domokos/RS485_device/MFG/6_ow_bus_device/6_ow_bus_device.png

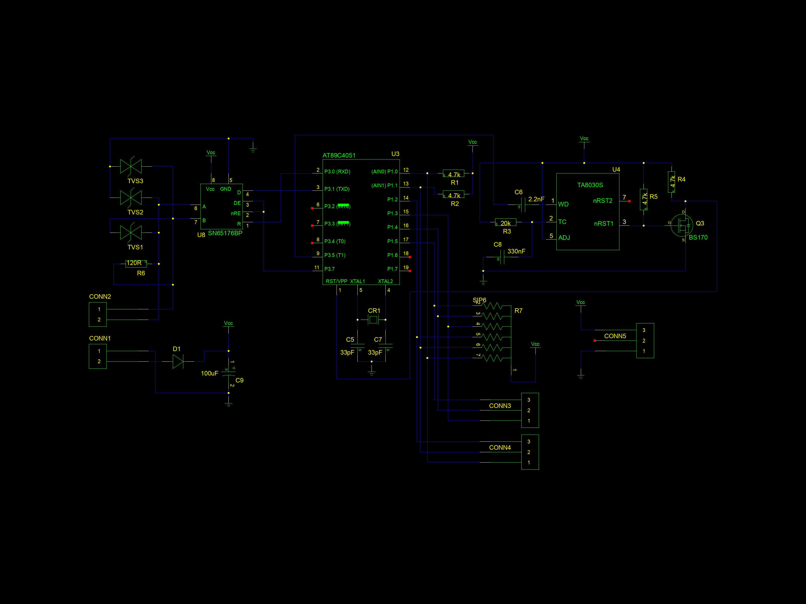
MFG/6_ow_bus_device/6_ow_bus_device.png
