domokos/RS485_device/MFG/master_controller/master_controller_v4.png

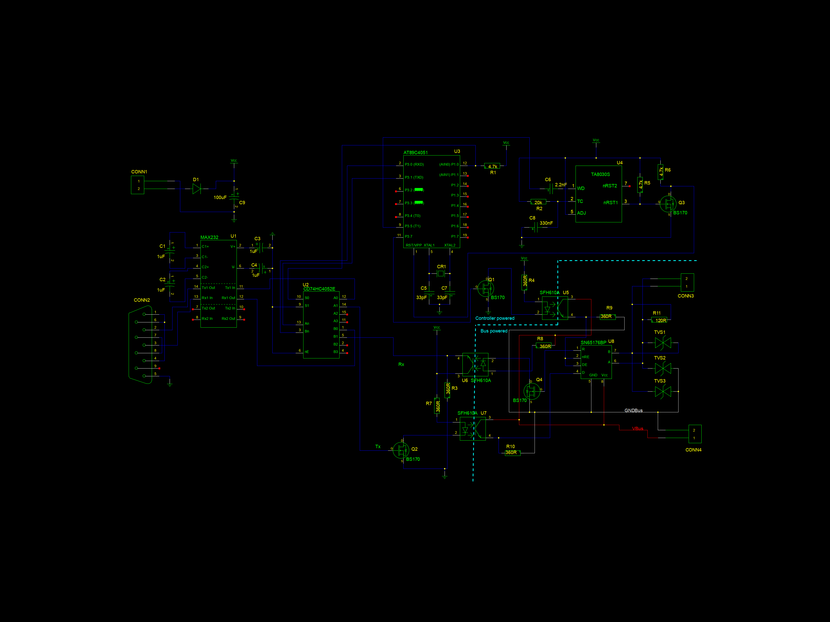
MFG/master_controller/master_controller_v4.png
