domokos/RS485_device/MFG/main_panel_device/230V_components.png

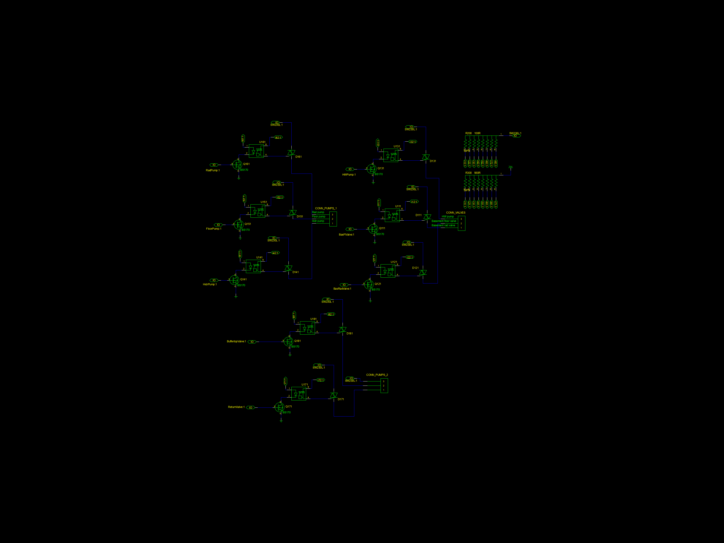
MFG/main_panel_device/230V_components.png
