domokos/RS485_device/MFG/main_panel_device/rs485_components.png

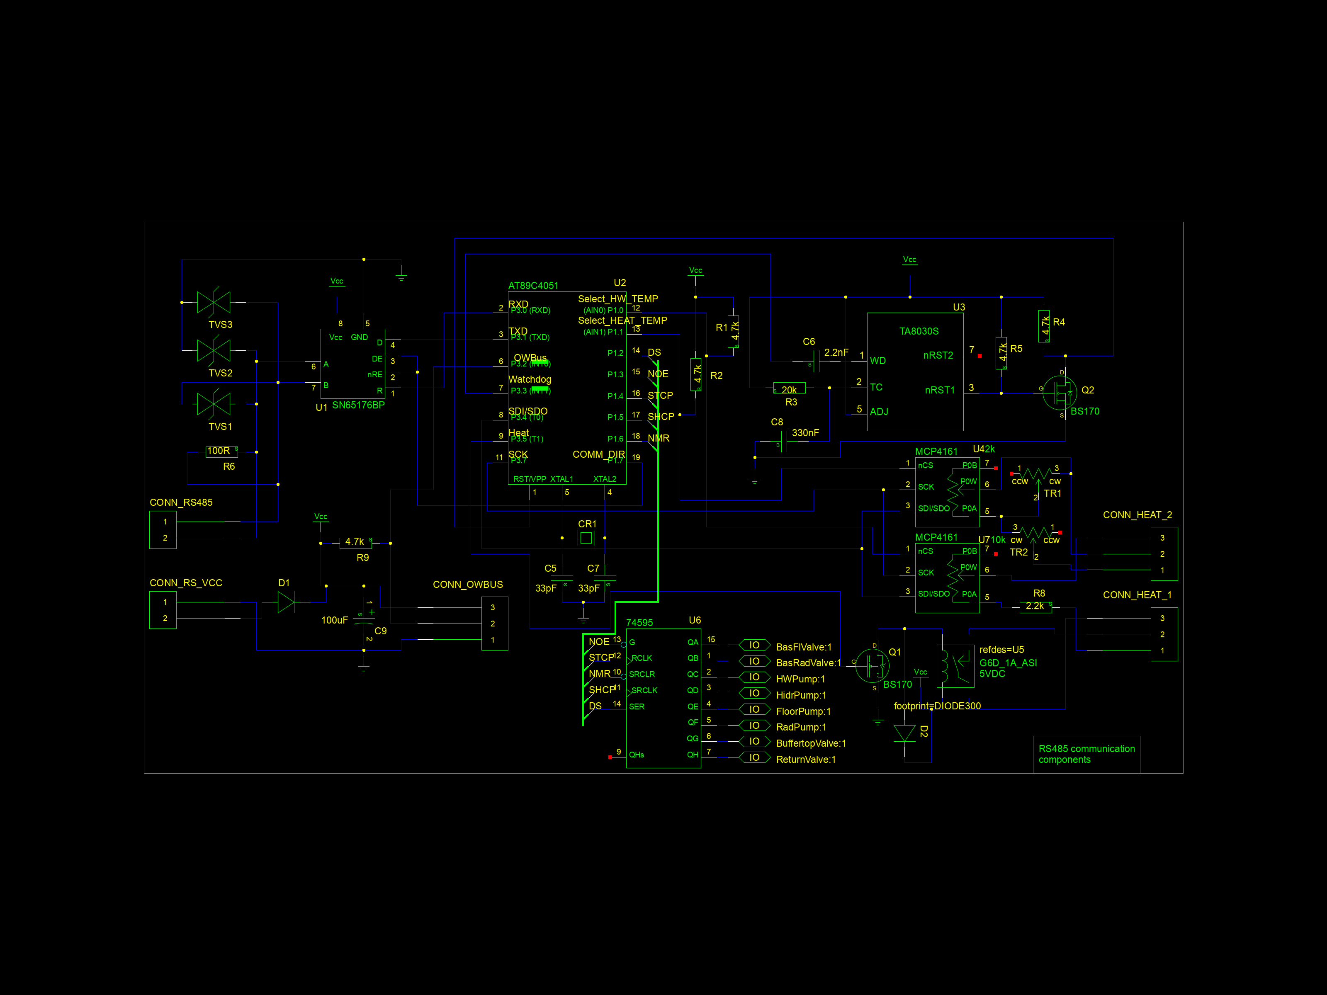
MFG/main_panel_device/rs485_components.png
