domokos/RS485_device/MFG/mixer_controller/230V_components.png

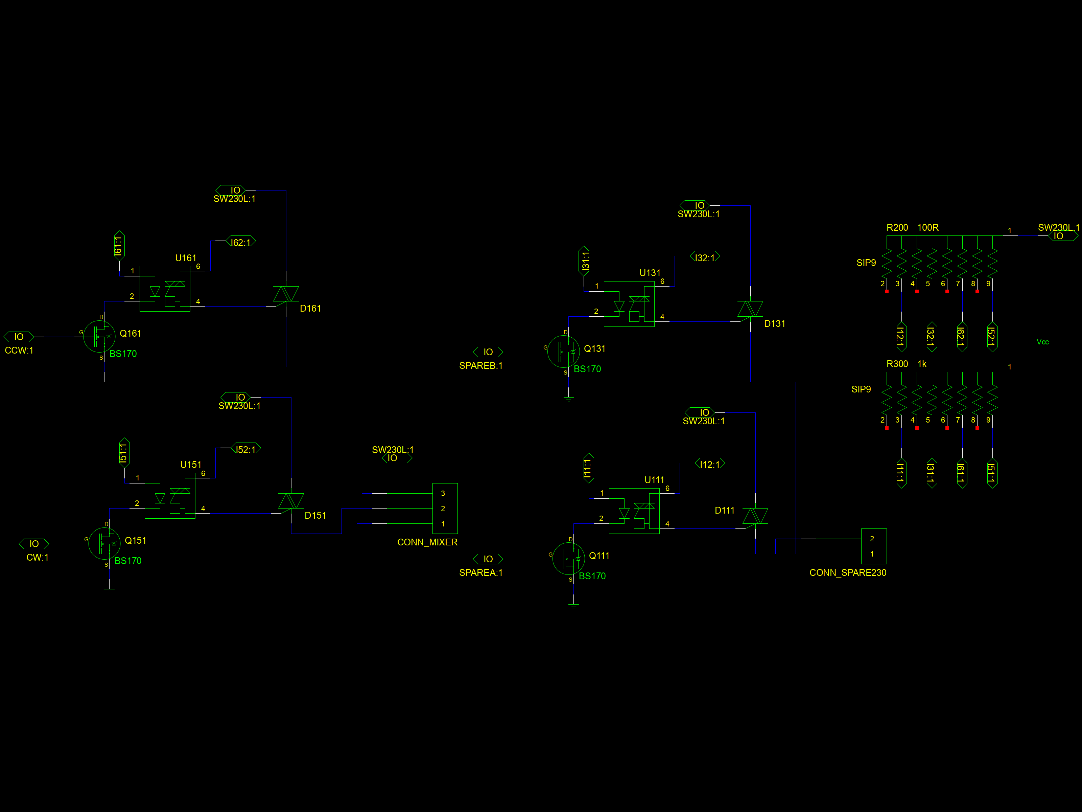
MFG/mixer_controller/230V_components.png
