domokos/RS485_device/MFG/mixer_controller/rs485_components.png

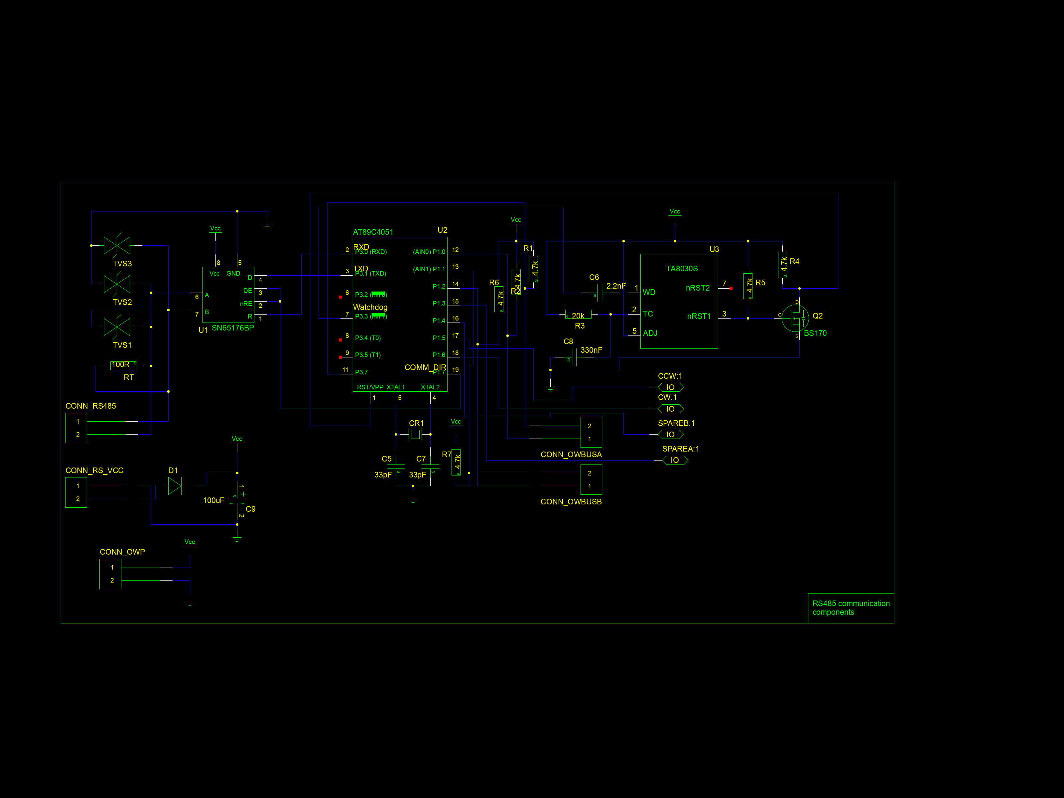
MFG/mixer_controller/rs485_components.png
