domokos/RS485_device/(list of files, drawings)

Other design files:
MFG/6_ow_bus_device/6_ow_bus_device.pcb
MFG/main_panel_device/main_panel_device.pcb
MFG/master_controller/master_controller_v4.pcb
MFG/mixer_controller/mixer_controller.pcb
