domokos/RS485_device/MFG/HP_device/HP_device.kicad_sch

## KiCad design MFG/HP_device/HP_device.kicad_sch (2022-10-01)

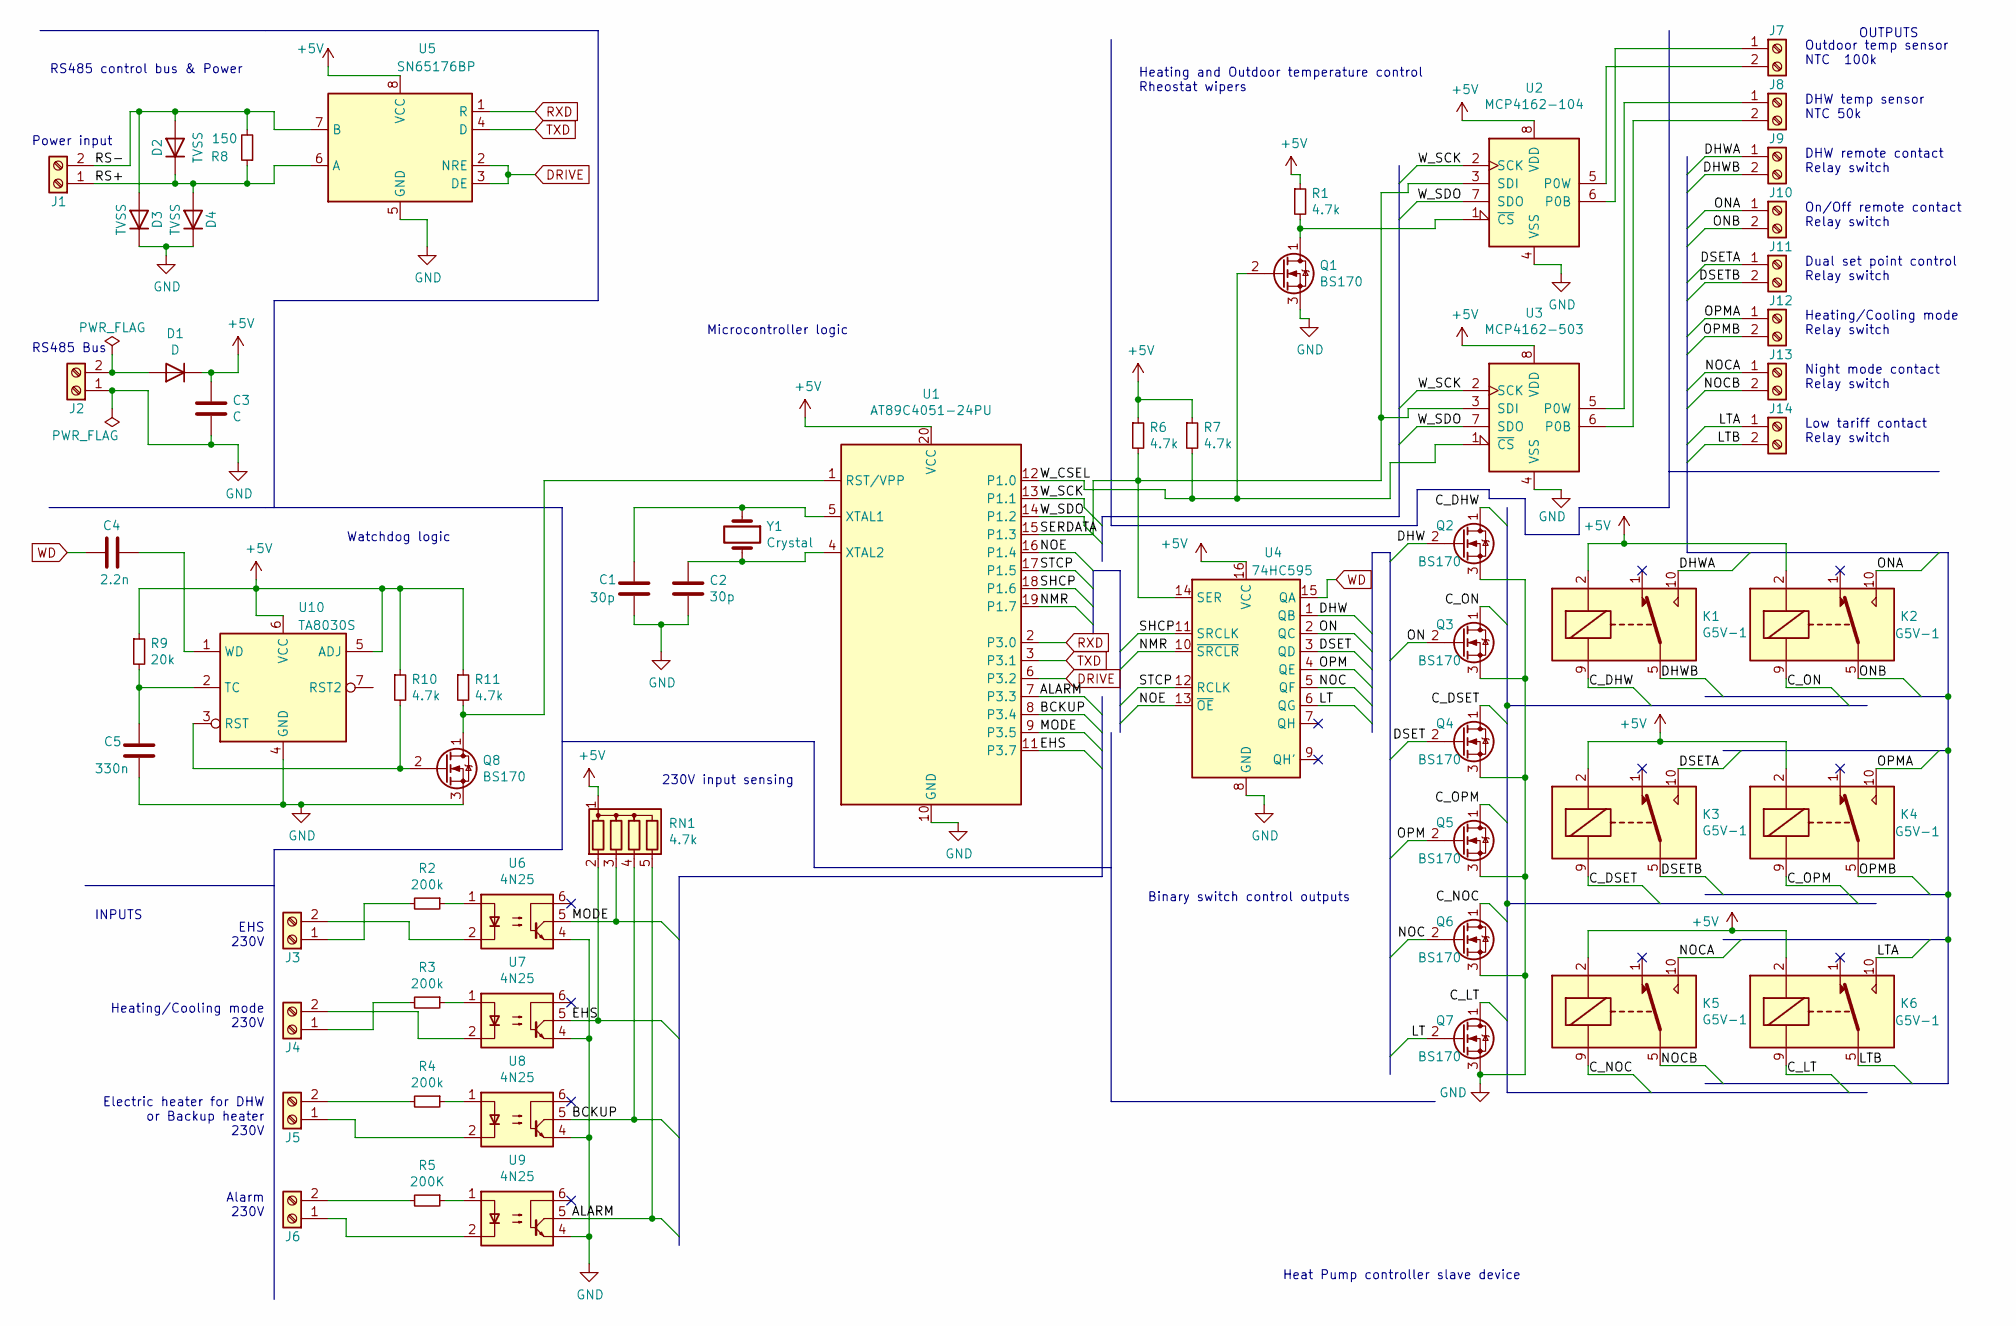
[picture p7: schematic HP_device.kicad_sch]

Parts:
C1, C2: 30p; C_Disc_D3.8mm_W2.6mm_P2.50mm
C3: C; C_Radial_D6.3mm_H11.0mm_P2.50mm
C4: 2.2n; C_Disc_D3.8mm_W2.6mm_P2.50mm
C5: 330n; C_Disc_D3.8mm_W2.6mm_P2.50mm
D1: D; D_A-405_P10.16mm_Horizontal
D2, D3, D4: TVSS; D_A-405_P10.16mm_Horizontal
J1, J2, J3, J4, J5, J6, J7, J8, J9, J10, J11, J12, J13, J14: Screw_Terminal_01x02; TerminalBlock_Phoenix_MKDS-1,5-2_1x02_P5.00mm_Horizontal
K1, K2, K3, K4, K5, K6: G5V-1; Relay_SPDT_Omron_G5V-1
Q1, Q2, Q3, Q4, Q5, Q6, Q7, Q8: BS170; TO-92_Inline
R1, R6, R7, R10, R11: 4.7k; R_Axial_DIN0204_L3.6mm_D1.6mm_P5.08mm_Horizontal
R2, R3, R4: 200k; R_Axial_DIN0309_L9.0mm_D3.2mm_P15.24mm_Horizontal
R5: 200K; R_Axial_DIN0309_L9.0mm_D3.2mm_P15.24mm_Horizontal
R8: 150; R_Axial_DIN0204_L3.6mm_D1.6mm_P5.08mm_Horizontal
R9: 20k; R_Axial_DIN0204_L3.6mm_D1.6mm_P5.08mm_Horizontal
RN1: 4.7k; R_Array_SIP5
U1: AT89C4051-24PU; DIP-20_W7.62mm
U2: MCP4162-104; DIP-8_W7.62mm
U3: MCP4162-503; DIP-8_W7.62mm
U4: 74HC595; DIP-16_W7.62mm
U5: SN65176BP; DIP-8_W7.62mm
U6, U7, U8, U9: 4N25; DIP-6_W7.62mm
U10: TA8030S; R_Array_SIP7
Y1: Crystal; Crystal_HC49-4H_Vertical

Connections:
+5V: C3.1, D1.1 (K), K1.2, K2.2, K3.2, K4.2, K5.2, K6.2, R1.1, R6.1, R7.1, R9.1, R10.1, R11.1, RN1.1 (common), U1.20 (VCC), U2.8 (VDD), U3.8 (VDD), U4.16 (VCC), U5.8 (VCC), U10.5 (ADJ), U10.6 (VCC)
ALARM: RN1.5 (R4), U1.7 (P3.3), U9.5
BCKUP: RN1.4 (R3), U1.8 (P3.4), U8.5
C_DHW: K1.9, Q2.1 (D)
C_DSET: K3.9, Q4.1 (D)
C_LT: K6.9, Q7.1 (D)
C_NOC: K5.9, Q6.1 (D)
C_ON: K2.9, Q3.1 (D)
C_OPM: K4.9, Q5.1 (D)
DHW: Q2.2 (G), U4.1 (QB)
DHWA: J9.1, K1.10
DHWB: J9.2, K1.5, K1.6
DRIVE: U1.6 (P3.2), U5.2 (NRE), U5.3 (DE)
DSET: Q4.2 (G), U4.3 (QD)
DSETA: J11.1, K3.10
DSETB: J11.2, K3.5, K3.6
EHS: RN1.2 (R1), U1.11 (P3.7), U7.5
GND: C1.2, C2.2, C3.2, C5.2, D3.1 (K), D4.1 (K), J2.1, Q1.3 (S), Q2.3 (S), Q3.3 (S), Q4.3 (S), Q5.3 (S), Q6.3 (S), Q7.3 (S), Q8.3 (S), U1.10 (GND), U2.4 (VSS), U3.4 (VSS), U4.8 (GND), U5.5 (GND), U6.4, U7.4, U8.4, U9.4, U10.4 (GND)
LT: Q7.2 (G), U4.6 (QG)
LTA: J14.1, K6.10
LTB: J14.2, K6.5, K6.6
MODE: RN1.3 (R2), U1.9 (P3.5), U6.5
NMR: U1.19 (P1.7), U4.10 (~SRCLR)
NOC: Q6.2 (G), U4.5 (QF)
NOCA: J13.1, K5.10
NOCB: J13.2, K5.5, K5.6
NOE: U1.16 (P1.4), U4.13 (~OE)
unnamed: C1.1, U1.5 (XTAL1), Y1.1
unnamed: C2.1, U1.4 (XTAL2), Y1.2
unnamed: C4.2, U10.1 (WD)
unnamed: C5.1, R9.2, U10.2 (TC)
unnamed: D1.2 (A), J2.2
unnamed: J3.1, R2.2
unnamed: J3.2, U6.2
unnamed: J4.1, R3.2
unnamed: J4.2, U7.2
unnamed: J5.1, U8.2
unnamed: J5.2, R4.2
unnamed: J6.1, U9.2
unnamed: J6.2, R5.2
unnamed: J7.1, U2.6 (P0B)
unnamed: J7.2, U2.5 (P0W)
unnamed: J8.1, U3.5 (P0W)
unnamed: J8.2, U3.6 (P0B)
unnamed: Q1.1 (D), R1.2, U2.1 (~CS)
unnamed: Q8.1 (D), R11.2, U1.1 (RST/VPP)
unnamed: Q8.2 (G), R10.2, U10.3 (RST)
unnamed: R2.1, U6.1
unnamed: R3.1, U7.1
unnamed: R4.1, U8.1
unnamed: R5.1, U9.1
ON: Q3.2 (G), U4.2 (QC)
ONA: J10.1, K2.10
ONB: J10.2, K2.5, K2.6
OPM: Q5.2 (G), U4.4 (QE)
OPMA: J12.1, K4.10
OPMB: J12.2, K4.5, K4.6
RS+: D2.1 (K), D4.2 (A), J1.1, R8.1, U5.6 (A)
RS-: D2.2 (A), D3.2 (A), J1.2, R8.2, U5.7 (B)
RXD: U1.2 (P3.0), U5.1 (R)
SERDATA: R6.2, U1.15 (P1.3), U2.3 (SDI), U3.3 (SDI), U4.14 (SER)
SHCP: U1.18 (P1.6), U4.11 (SRCLK)
STCP: U1.17 (P1.5), U4.12 (RCLK)
TXD: U1.3 (P3.1), U5.4 (D)
WD: C4.1, U4.15 (QA)
W_CSEL: Q1.2 (G), R7.2, U1.12 (P1.0), U3.1 (~CS)
W_SCK: U1.13 (P1.1), U2.2 (SCK), U3.2 (SCK)
W_SDO: U1.14 (P1.2), U2.7 (SDO), U3.7 (SDO)

Notes on the sheet:
DHW temp sensor NTC 50k
Outdoor temp sensor NTC 100k
Dual set point control Relay switch
Heat Pump controller slave device
DHW remote contact Relay switch
Binary switch control outputs
OUTPUTS
Low tariff contact Relay switch
Heating and Outdoor temperature control Rheostat wipers
Heating/Cooling mode Relay switch
On/Off remote contact Relay switch
Watchdog logic
EHS 230V
Night mode contact Relay switch
RS485 control bus & Power
RS485 Bus
Microcontroller logic
Electric heater for DHW or Backup heater 230V
Alarm 230V
230V input sensing
Heating/Cooling mode 230V
INPUTS
Power input
