domokos/RS485_device/Devices/Mixer_controller.h

/*
 * Mixer_controller.h
 *
 *  Created on: Jan 30, 2015
 *      Author: dmolnar
 */

#ifndef MIXER_CONTROLLER_H_
#define MIXER_CONTROLLER_H_

#include "Slave_comm.h"

typedef enum {DIRECTION_CW, DIRECTION_CCW} direction_type;

#endif /* MIXER_CONTROLLER_H_ */
