domokos/RS485_device/Devices/Master_controller.h

/*
 * Master_controller.h
 *
 *  Created on: Feb 18, 2013
 *      Author: dmolnar
 */

#ifndef MASTER_CONTROLLER_H_
#define MASTER_CONTROLLER_H_

#include "Master_comm.h"

#endif /* MASTER_CONTROLLER_H_ */
