domokos/RS485_device/(commit log)

2012-10-29 Fix ignoring build componenst on desktop.
    [Comm.c]
2012-10-29 Fix encoding to ISO-8859-2.
    [Comm.c]
2012-10-30 Correct typo of buffer clearing.
    [Comm.c]
2012-10-30 Review and fix message escaping logic
    [Comm.c]
2012-10-31 Fix: Put ISR prototypes in the same file that contains main().
    [Base.c, Base.h, Comm.c, Comm.h]
2012-11-01 Fix interrupt enable and send buffer numbering.
    [Base.c, Comm.c, Comm.h]
2012-11-01 Fix messaging logic sync based on emulator tests.
    [Comm.c, Comm.h]
2012-11-04 Implement flip_bit - not yet tested
    [Comm.c, Comm.h]
2012-11-05 Clear up flip_bits function.
    [Comm.c]
2012-11-06 Bring bit flipping into the crc calculation. Not yet tested in emulator.
    [Comm.c]
2012-11-06 16 bit CSR calculation works with flippped bits in ermulator.
    [Comm.c, Comm.h]
2013-01-29 Create own header file for at89c4051 registers to handle eclipse errors.
    [Base.c, Base.h, Comm.c, Comm.h, at89c4051.h]
2013-02-07 Fix documetation typos and cleanup prev_recieved char in Comm.c
    [Comm.c, Comm.h]
2013-02-11 Fix some typo in comments and in CRC_ERROR #define
    [Comm.h]
2013-02-13 Add a second train to the end of the message to ensure bus direction timing correctness
    [Comm.c]
2013-02-16 Cleanup and implement circular buffer based UART communication
2013-02-18 Reorganize into devices and master controller step1
2013-02-18 Fix macros in headers
    [Comm.h, Comm_common.h]
2013-02-19 Start implementing timer1 clock based messaging timeout counter for reliability and for bus master messaging timeout measurements.
2013-02-20 Update calculations
    [Timeout_calculation.xlsx]
2013-02-21 Reorganized delay and timeout to correct time base and test it in emulator.
    [Base.c, Base.h, Comm_common.c, Comm_common.h, Master_comm.c, Slave_comm.c, Slave_comm.h]
2013-02-23 Workaround SDCC bug. Tested on protoboard. Works.
    [Comm_common.c, Comm_common.h, Master_comm.c]
2013-03-01 Start temp measuring device and reorganize comm_speed based on two crystal speeds.
2013-03-01 Reorganized for generic device.
    [Timeout_calculation.xlsx]
2013-03-02 Start temp reader device testing in emulator.
2013-03-03 Communicates temperature correctly on protoboard.
    [Base.c, Base.h, Onewire.c]
2013-03-04 Investigating timeout. Not yet found.
    Device sometimes does not respond to messages getting to UART pin for
    unknown reason.
2013-03-06 COmm error rate down to 4%. Hmmmm.
    [Comm_common.c, Comm_common.h, Generic_device.c]
2013-03-06 Still errors a bit.
    [Comm_common.c, Comm_common.h]
2013-03-06 Fixed timeout errors. Timeout error rate below 0.1%
    [Base.c, Comm_common.c]
2013-03-12 Refine timer in Base and equalize interrupt priorities
2013-03-12 Change watchdog pin.
2013-03-12 Add schematics
    [master_controller.sch]
2013-03-13 Start drawing schematic.
    [master_controller.sch]
2013-03-14 Finish schematic.
    [master_controller.sch]
2013-03-14 Add resistor to opto source.
    [master_controller.sch]
2013-03-15 Add symbols, finalize schematic.
    [master_controller.sch]
2013-03-15 Schematics refining
    [master_controller.sch]
2013-03-15 Finalize resistor values.
    [master_controller.sch]
2013-03-16 Change crystal frequency and make init timer pulic.
2013-03-16 Reorganize schematics and pcbs
    [master_controller.pcb, master_controller.sch]
2013-03-17 Work on pcb
    [master_controller.pcb, master_controller.sch]
2013-03-17 Finish PCB board.
    [master_controller.pcb, master_controller.sch]
2013-03-17 Refine serial tx.
    [master_controller.pcb]
2013-03-17 fix packaging of optocoupler.
    [master_controller.sch]
2013-03-18 Refine pcb once more.
    [master_controller.pcb, master_controller.sch]
2013-03-18 Add onewire 3 device
    [3_ow_bus_device.pcb, 3_ow_bus_device.sch]
2013-03-20 Rename things
    [6_ow_bus_device.pcb, 6_ow_bus_device.sch]
2013-03-21 CONN3.fp added
    [3_ow_bus_device.pcb, 3_ow_bus_device.sch]
2013-03-21 Finalize elements in ow6 layout
    [6_ow_bus_device.pcb]
2013-03-21 Finish PCB
    [6_ow_bus_device.pcb]
2013-03-21 fixups on layout.
    [6_ow_bus_device.pcb, 6_ow_bus_device.sch]
2013-03-22 Prited PCBs.
    [6_ow_bus_device.pcb, master_controller.pcb]
2013-03-23 Add alignment marks to PCB layout
    [6_ow_bus_device.pcb, master_controller.pcb]
2013-03-25 Test the panel. MOdify watchdog resistor and ADJ values.
    [6_ow_bus_device.pcb, 6_ow_bus_device.sch, master_controller.pcb, master_controller.sch]
2013-03-29 Start drawing switch panel device
    [6_ow_bus_device.pcb, switch_panel_device.sch]
2013-03-30 Add structure for main panel device based on generid test device.
2013-04-01 PWM is complete. Need to add PWM mesage handling before testing.
2013-04-02 Implemented multiple OW devices on a single bus. Needs testing.
2013-04-02 PWM and single OW tested in hardware. Works. To be tested mutiple OW on a bus.
2013-04-03 Reorganize PWM
2013-04-03 OPtimize PWM state machine.
2013-04-03 Tested in device. Works.
2013-04-08 ROM ID read succesfully with test device.
2013-04-09 Multiple OW devices on single bus works, tested in Main Panel Device.
2013-04-11 Reorganize panels and add comm safety to Master controller.
    [kazan_a_v3.sch, kazan_b_v3.sch, main_panel_device.sch]
2013-04-13 Prepare branching comm for interrupt driven serial receiving.
2013-04-13 Fix eclipse parser mocking.
    [Base.h]
2013-04-15 Timeputing fixed, now test why master controller sends a short message to the bus sometimes.
    [Comm_common.c]
2013-04-16 Some ISR-receiver hadshaking and timeout fixes before testing.
    [Comm_common.c]
2013-08-04 Modify layout of 6owbus - join powe & GND lines to a single connector.
    [6_ow_bus_device.pcb, 6_ow_bus_device.sch]
2013-08-23 Add 6 ow bus device.
2013-08-25 OW interface of 6 OW bus device tested.
2013-08-28 Add alternative Master controller PCB
    [master_controller_v2.pcb]
2013-08-29 New master controller version (v3)
    [master_controller_v3.pcb]
2013-08-31 Modify master controller layout
    [master_controller_v3.pcb]
2013-08-31 Fine tune master controller pcb
    [master_controller_v3.pcb, master_controller_v3.sch]
2013-09-01 Finalize Master controller PCB layout
    [master_controller_v3.pcb]
2013-09-03 Fine tune layout and add printed ps file
    [master_controller_v3.pcb]
2013-09-16 Fix optocoupler in master_controller MFG
    [master_controller_v3.pcb, master_controller_v3.sch]
2013-10-01 New version of master_controller MFG
    [master_controller_v4.pcb, master_controller_v4.sch]
2013-12-28 Continue Design of main panel device
    [230V_components.sch, 230V_control.sch, rs485_components.sch]
2014-01-05 Refine main?panel_device and clenup master controller old versions.
    [230V_components.sch, 230V_control.sch, master_controller.sch, master_controller_v2.pcb, master_controller_v3.pcb, master_controller_v3.sch, rs485_components.sch]
2014-01-19 Main controller PCB design started
    [230V_components.sch, 230V_control.sch, main_panel_device.pcb]
2014-01-19 Further elaborate main controller MFG.
    [230V_components.sch, 230V_control.sch, main_panel_device.pcb, rs485_components.sch]
2014-01-23 Fix missing resistor and add 230V signal components
    [230V_control.sch, main_panel_device.pcb]
2014-01-25 Create 230V parts of board
    [main_panel_device.pcb]
2014-01-26 Finish first version of PCB fine tune layout connections.
    [230V_components.sch, main_panel_device.pcb, rs485_components.sch]
2014-02-08 Fix wirting of optocoupler inputs.
    [230V_control.sch, main_panel_device.pcb]
2014-02-08 fix capacitor value for 230V components.
    [230V_control.sch]
2014-03-03 Change 230V capacitor to a bigger one.
    [230V_control.sch, main_panel_device.pcb]
2014-03-16 Add a different size line capacitor.
    [main_panel_device.pcb]
2014-03-17 Fine tune layout
    [main_panel_device.pcb]
2014-05-02 Add text and alignment mark to main panel PCB
    [main_panel_device.pcb]
2014-11-13 Modify main panel device for new condensing boiler.
    [230V_components.sch, 230V_control.sch, kazan_a_v3.sch, kazan_b_v3.sch, main_panel_device.pcb, rs485_components.sch]
2014-11-17 Revert a file
    [230V_components.sch, rs485_components.sch]
2014-11-17 Refine layout
    [main_panel_device.pcb, rs485_components.sch]
2014-11-18 Finalize board before printing
    [main_panel_device.pcb]
2014-11-23 Finalize layout. Correct Triac pinout and schematic.
    [230V_components.sch, main_panel_device.pcb, rs485_components.sch]
2014-11-23 Fix relay pcb in main panel board
    [main_panel_device.pcb]
2014-11-25 Fixed missing component from main panel device
    [main_panel_device.pcb, rs485_components.sch]
2014-11-26 Fixes of the main panel device after first debugging session.
    [master_controller.pcb]
2014-11-27 Fix spi timing for MCP4161
    [MCP4161.c, MCP4161.h]
2014-11-30 Onewire device addresses set for final operation.
2014-12-01 Fix HW problems and test.
    [Main_panel_device.c]
2014-12-01 Fix scaling of DS18B20 to 12 bit value (multiply with 0.625 to get real temperature)
    [Main_panel_device.c]
2014-12-01 Fix typo in scaling
    [Main_panel_device.c, Main_panel_device.h]
2014-12-07 Re-fix wiper write volatility
    [MCP4161.c]
2014-12-07 Fix reading wiper volatility flag
    [Main_panel_device.c]
2014-12-14 Branch for time-distributed sensor read on the single bus
2014-12-15 Rework main panel schematic
    [rs485_components.sch]
2014-12-16 Finalize schematics - add 2 new switches and a rheostat
    [230V_components.sch, rs485_components.sch]
2014-12-16 Fix missing elemnt refdes' and update layout - now complete with elements.
    [230V_components.sch, main_panel_device.pcb, rs485_components.sch]
2014-12-16 Add original rheostat drawing
    [rheostat.sch]
2014-12-17 Start working on pcb layout
    [230V_components.sch, main_panel_device.pcb, rs485_components.sch]
2014-12-18 Develop layout further
    Please enter the commit message for your changes. Lines starting
    [main_panel_device.pcb, rs485_components.sch]
2014-12-18 Finish Layout
    [230V_components.sch, main_panel_device.pcb, rs485_components.sch]
2014-12-18 Reduce vias in the pcb
    [main_panel_device.pcb]
2014-12-19 Remove some vias
    [main_panel_device.pcb]
2014-12-19 Add attachment hole measure to the pcb
    [main_panel_device.pcb]
2014-12-24 Add mounting holes to pcb
    [230V_components.sch, main_panel_device.pcb, rs485_components.sch]
2014-12-25 Reorganize board to make moore room
    [main_panel_device.pcb]
2014-12-25 Finalize layout
    [main_panel_device.pcb, rs485_components.sch]
2014-12-26 Create hidraulic schematic
    [hirdaulic_drawing.sch]
2014-12-26 Add alignment marks to the pcb layout
    [main_panel_device.pcb]
2014-12-26 Rename file
    [hidraulic_drawing.sch]
2014-12-27 Modify hidraulic drawing
    [hidraulic_drawing.sch]
2014-12-28 Ready to test Buffer branch in real HW
    [230V_components.sch, main_panel_device.pcb, rs485_components.sch]
2014-12-29 MOve main panel device to single extender code
2014-12-29 Adjust main panel device inactivity self-reset timeout to 30 sec
    [Slave_comm.h]
2014-12-31 Disable messaging timeout as it did not work.
    [Main_panel_device.c]
2014-12-31 Fix a timer interrupt race condition and re-enable bus communication timeout code
    [Base.c, Main_panel_device.c]
2014-12-31 Fix pinlayout defines by introducing device specfic compiler defines
    [Base.h, Master_comm.c, Pinlayout.h, Slave_comm.c]
2014-12-31 Make all pind device type define dependent
2015-01-01 Fix defines for Exclipes CDT parser
    [Pinlayout.h]
2015-01-03 Fix typo of Exclipse parser name
    [Pinlayout.h]
2015-01-03 Start HW testing six owbus device
2015-01-03 HW assembled for testing
2015-01-03 Fix direction pin
2015-01-03 Swap search byte order
    [Onewire.c]
2015-01-03 Fix typos in debug code
    [Onewire.c]
2015-01-03 Restore real device addresses
2015-01-04 Fix ow temp measurement initiation
    [Six_owbus_device.c]
2015-01-04 Fix addressing of registers
    [Six_owbus_device.c]
2015-01-30 Create new device - compiles
2015-02-03 Add layout elements for mixer controller
    [230V_components.sch, rs485_components.sch]
2015-02-04 Finish schematic - create initial PCB
    [230V_components.sch, mixer_controller.pcb, rs485_components.sch]
2015-02-06 Finalize layout of mixer controller
    [230V_components.sch, mixer_controller.pcb, rs485_components.sch]
2015-02-06 Fix dirll sizes and DRC issues of the layout
    [mixer_controller.pcb]
2015-05-31 Fix typo of interrupt vector name
2015-11-22 Set addresses of forwar and return temp sensors
2016-01-03 Change address of upstairs sensor
2018-12-28 Lower value of optocoupler trigger current resistor to increase current. Add pullup resistor to onewrire bus Suppress compiler warnings.
    [230V_components.sch, 6_ow_bus_device.pcb, 6_ow_bus_device.sch, main_panel_device.pcb, rs485_components.sch]
2019-10-05 Add an extra sensor to MixerController device
2022-10-01 Fix compiler upgrade problem - & and > operator precedence...
    [HP_device-B_Cu.gbr, HP_device-B_Mask.gbr, HP_device-B_Silkscreen.gbr, HP_device-Edge_Cuts.gbr, HP_device-F_Cu.gbr, HP_device-F_Mask.gbr, HP_device-F_Silkscreen.gbr, HP_device-NPTH.drl]
2022-10-16 Rename sensors n comments / no logic change
